jskonst/companyLamp/mech/README.md

# Корпус лампы под плафон VL0079 (E14)

Параметрическая модель OpenSCAD. Плафон **VL0079** (белый пластик, E14, усечённый конус) ставится нижним краем (~101 мм) в **мелкий паз** основания (`SEAT_DEPTH = 6` мм, как `depth` в эскизе) и прижимается сверху **кольцом на N_SNAPS = 6 защёлках** (как `CaseCap.scad`, резьба заменена защёлками).

Библиотека: [BOSL2](https://github.com/BelfrySCAD/BOSL2), лежит в `mech/lib/BOSL2` (из списка openscad.org/libraries). Используются `tube`, `cyl`, `cuboid`, `prismoid`, `rect_tube`, `zrot_copies`, `grid_copies`, `torus`.

В `mech/lib/BOSL2` оставлены только `std.scad`, файлы, которые он подключает, `builtins.scad` и `LICENSE`. Для других модулей BOSL2 (threading, joiners и т.д.) скопируйте нужный файл из апстрима.

## Файлы
- `scad/params.scad` — все размеры, оценки помечены `[EST]`.
- `scad/lamp.scad` — модули и сборка, `PART = assembly | exploded | base | cover | latch_ring | pipe | led_ring`.
- `stl/` — `base.stl`, `cover.stl`, `latch_ring.stl`, `pipe.stl`, `led_ring.stl`.
- `renders/assembly.png`, `renders/exploded.png`.

## Узлы
- **Основание**: конус отсека электроники (BAY_H 40 мм), палуба под LED-кольцо, мелкий паз под край плафона: стакан снаружи + бортик 4 мм изнутри, снаружи стакана буртик под зубья. В центре декоративный «патрон E14», он же кабельный ввод провода ленты (Ø5).
- **Прижимное кольцо** (`latch_ring.stl`): кольцо 3 мм с конусным отверстием по профилю плафона, надевается на плафон сверху и давит на него у края; 6 лапок 8×1.6 мм вниз, зуб с фаской защёлкивается под буртик стакана. Снять: отжать лапки.
- **LED-кольцо** 86/72 мм (как `ring.scad`), 24 × WS2812 светят вверх в плафон.
- **Световод AP-индикатора**: канал Ø4 от бока корпуса к leds[0] (угол 0°). Видно, не снимая плафон.
- **Кнопка** GPIO16: отверстие Ø7 спереди, толкатель для тактовой 6×6.
- **USB-C** зарядки в задней стенке, рядом вентиляционные прорези. Ещё прорези в дне под платой питания.
- **Узлы на палубе основания** (висят вниз): стойки Lolin M2 (28×18, h 10), рамка платы питания 35×50 у задней стенки (USB-C наружу), 18650 поперёк по центру (отсек 22×77×20), Lolin спереди; (TP4056 + boost 5 В ≥2 А), отсек 18650 при `WITH_BATTERY=true`. **Крышка дна** на 3 защёлках — только прижимные рёбра снизу (под края платы питания, Lolin и два ложемента 18650) и петля под стяжку.

## Электрика (напоминание)
Лента только от 5 В (boost), никогда от 3.3 В. 1000 мкФ на входе ленты, 330 Ом в линию данных GPIO14, общая земля.

## Печать
- PETG (лучше пружинит, защёлки не ломаются) или ABS. PLA подходит, но тогда `SNAP_T = 1.8`.
- Основание печатать юбкой вверх без поддержек, крышку плашмя. Слой 0.2, 3 периметра.
- Печать с шарнирами (print-in-place) не нужна: 4 отдельные детали.

## Открытые вопросы
- Точные размеры VL0079: нижний диаметр (наружный и внутренний), верх, отверстие E14, высота, есть ли у края валик или буртик. Если есть, зуб защёлки лучше развернуть под него.
- Элемент питания: 18650 или LiPo 1S ~1000 мАч (тогда отсек меньше).
- Ревизия Lolin D1 mini (v3 / v4 / Pro), точная плата зарядки и boost.
- Перед печатью всей детали стоит напечатать пробное кольцо юбки с защёлками.
