jskonst/companyLamp/hardware/power.md

# Питание и электроника companyLamp (корпус VL0079)

Плата: Wemos/Lolin D1 mini (ESP8266). Корпус: `mech/scad` (`params.scad`).

## Цепь питания

```
USB-C (задняя стенка) → TP4056 + защита (DW01/FS8205) → шина АКБ 3.0–4.2 В (18650, WITH_BATTERY)
        → boost 5 В ≥2 А ─┬→ лента/кольцо WS2812 ×24 (5V, GND)
                          └→ D1 mini пин 5V → его LDO 3.3 В → логика ESP8266
Все GND общие (АКБ−/OUT−, boost, лента, D1 mini).
```

- Ленту **никогда** не питать от 3V3 D1 mini (LDO ~500 мА, лента до 1.44 А).
- Без АКБ (`WITH_BATTERY=false`): USB-C 5 В ≥2 А напрямую на шину 5 В.
- Boost подключать к выходу защиты (OUT+/OUT−), не к B+ напрямую.

## Токи

| Потребитель | Ток |
|---|---|
| 24 × WS2812, белый 100 % | до ~1.44 А (60 мА/шт) |
| ESP8266 Wi‑Fi AP+STA, пики | 300–400 мА (3.3 В) |
| Лимит в прошивке | `FastLED.setMaxPowerInVoltsAndMilliamps(5, 800)` |

Boost берёт из 18650 ~ I×5/(3.7×0.9): при 1.2 А на 5 В — ~1.8 А из АКБ. Ячейка ≥2 А разряда, зарядка TP4056 1 А (R_prog 1.2 кОм).

## Сигналы

| Функция | GPIO | D1 mini | Примечание |
|---|---|---|---|
| Данные WS2812 | 5 | D1 | 330 Ом последовательно у первого светодиода; 1000 мкФ/10 В между 5V–GND на входе кольца |
| Кнопка | 14 | D5 | `BTN_LEVEL 1` (на 3V3) → внешний 10 кОм на GND (у GPIO14 есть только pull-up, pull-down нет); отверстие Ø7 спереди, тактовая 6×6 |
| Индикатор AP | — | — | `leds[0]` кольца через световод Ø4 (`PIPE_D`), отдельного LED нет |
| PIR | **D6 / GPIO12** | — | `USE_PIR 0` по умолчанию; запасной вариант D7/GPIO13 |

Данные 3.3 В на ленте 5 В обычно работают; при сбоях — 74AHCT125 или питание ленты ~4.6 В через диод.

## Посадочные места (params.scad)

| Узел | Размер |
|---|---|
| Lolin D1 mini | 34.2×25.6 мм, отверстия 28×18, M2, стойки 10 мм |
| Плата питания (TP4056 + boost) | рамка 35×50 мм (повёрнута), USB-C на короткой стороне к задней стенке [EST — до реальной платы зарядки] |
| 18650 в держателе | отсек 22×77×20 мм (под держатель 1×18650) |
| Ячейка 18650 (`BATT_CELL`) | Ø18.5×70 мм, отдельно от держателя |
| USB-C | окно 9.5×3.6 мм, задняя стенка |
| Кабель ленты | Ø5 через декоративный E14 |

## Прошивка

Micro-USB D1 mini (CH340), `pio run -e d1_mini -t upload`, монитор 115200. Micro-USB Lolin внутри корпуса и снаружи недоступен: прошивка со снятой крышкой дна или по OTA (`pio run -e d1_mini_ota -t upload --upload-port <ip>`, пароль в README). USB-C на задней стенке — только зарядка/питание, не данные.
