jskonst/companyLamp/FEATURES.md

# WebLamp — спецификация

**Концепция:** несколько ламп в офисе/команде общаются через MQTT и реагируют друг
на друга. Каждая лампа — личный инструмент фокуса и коммуникации для одного человека.

**Железо:** ESP8266 (D1 Mini), кольцо из 24 адресных WS2812B, кнопка, PIR-датчик.

---

## Кольцо из 24 LED

Кольцо — основной экран лампы. 24 светодиода делятся на **6 секций по 4 LED**,
каждая секция соответствует одному из режимов. Нумерация секций по часовой стрелке.

```
Секция 1 (LED 0–3)   → режим «Лампа»
Секция 2 (LED 4–7)   → режим «Помодоро»
Секция 3 (LED 8–11)  → режим «Настроение»
Секция 4 (LED 12–15) → режим «Настроение команды»
Секция 5 (LED 16–19) → режим «Позвать на митинг»
Секция 6 (LED 20–23) → режим «Не беспокоить»
```

---

## Управление кнопкой — общая модель

| Жест | Действие |
|---|---|
| **1 клик** | Основное действие текущего режима |
| **2 клика** | Вторичное действие текущего режима |
| **Удержание** | Аналоговое действие (яркость, цвет) |
| **3 клика** | Следующий циклический режим: Лампа → Помодоро → Настроение → Лампа |
| **4 клика** | Вкл / выкл DND с возвратом в предыдущий режим |

DND не входит в обычный цикл режимов и включается отдельным жестом.

### Индикатор режима при переключении
При смене режима или переключении DND:
1. Кольцо гаснет.
2. Загорается секция текущего режима (цвет секции — фиксированный, см. таблицу режимов).
3. Через ~2 секунды кольцо возвращается к отображению активного режима.

---

## Режимы

### Режим 1 — Лампа (базовое освещение)

**Индикатор:** секция 1 горит тёплым белым.

**Кнопка:**

| Жест | Действие |
|---|---|
| 1 клик | Вкл / выкл |
| 2 клика | Следующий цвет (+шаг по HSV, 8 цветов по кругу) |
| Удержание | Яркость: растёт до 100%, затем убывает до 0%, направление меняется на границах |

**Внешние сигналы (MQTT):** могут временно прервать отображение (мигнуть при
входящем сигнале), после завершения лампа возвращается к своему состоянию.

---

### Режим 2 — Помодоро

**Индикатор:** секция 2 горит оранжевым.

**Суть:** таймер по технике Помодоро — чередование рабочих интервалов и перерывов.
Прогресс визуализируется последовательным заполнением кольца LED-ами.

#### Настройки (веб-интерфейс)
- Длительность рабочего интервала (мин)
- Длительность короткого перерыва (мин)
- Длительность длинного перерыва (мин, после N помодоро)
- Количество помодоро до длинного перерыва
- Цвет рабочего интервала (используется как сигнал «не беспокоить»)

#### Визуализация прогресса
- Кольцо заполняется по часовой стрелке пропорционально прошедшему времени.
- Цвет заполнения: **рабочий цвет** во время работы, **зелёный** во время перерыва.
- Незаполненные LED выключены или очень тусклые (фоновая подсветка).

#### Состояния и кнопка

| Состояние | 1 клик | 2 клика |
|---|---|---|
| **Ожидание** (таймер не запущен) | Запустить первый интервал | — |
| **Идёт интервал** | Пауза / продолжить | Пропустить к следующему интервалу |
| **Интервал завершён** (мигает) | Подтвердить (мигание стоп) | — |
| **Подтверждено** (ждёт запуска) | Запустить следующий интервал | Пропустить следующий интервал |

При завершении интервала: кольцо **мигает** несколько раз и ждёт нажатия.
Первое нажатие — останавливает мигание. Второе — запускает следующий интервал.

#### Связь с MQTT
- Во время **рабочего** интервала автоматически рассылает сигнал «не беспокоить»
  (если лампа онлайн), используя настроенный рабочий цвет.
- Перерыв — сигнал «не беспокоить» снимается.

#### Офлайн
Помодоро работает полностью локально без MQTT.

---

### Режим 3 — Настроение

**Индикатор:** секция 3 горит цветом текущего настроения пользователя.

**Суть:** пользователь выставляет своё настроение цветом от зелёного (хорошо)
через жёлтый к красному (плохо). Отправляется в сеть и учитывается в среднем
настроении команды.

**Цветовая шкала настроения:**
```
Зелёный (120°) → Жёлто-зелёный → Жёлтый (60°) → Оранжевый → Красный (0°)
    Отлично                          Нормально                     Плохо
```

#### Кнопка

| Жест | Действие |
|---|---|
| Удержание | Прокрутка цвета настроения (зелёный → красный → зелёный) |
| 1 клик | Подтвердить и отправить настроение (если онлайн) |

Настроение также можно выставить через веб-интерфейс.

#### MQTT
- При подтверждении отправляет HSV-оттенок на брокер.
- Настроение **сбрасывается ежедневно** (в 00:00 или при перезагрузке на следующий день).

#### Офлайн
Настроение сохраняется локально, публикуется при восстановлении связи.

---

### Режим 4 — Настроение команды

**Индикатор:** секция 4 горит цветом среднего настроения.

**Суть:** только чтение. Показывает среднее настроение всех ламп в сети за
текущий день. Обновляется при получении нового значения настроения от коллег.

**Визуализация:**
- Всё кольцо горит цветом среднего настроения (тот же диапазон зелёный–красный).
- Если данных нет — кольцо тускло белое или не горит.

**Кнопка:** нет активных действий (только общий переход по 3 кликам и DND по 4 кликам).

**Сброс:** ежедневно, вместе с личным настроением.

---

### Режим 5 — Позвать на митинг

**Индикатор:** секция 5 горит синим.

**Суть:** одно нажатие рассылает сигнал всем лампам в сети — у всех **мигают**
лампы, привлекая внимание.

#### Кнопка

| Жест | Действие |
|---|---|
| 1 клик | Отправить сигнал митинга (мигание всех ламп в сети) |
| 2 клика | Подтвердить участие во входящем сигнале митинга |

#### Входящий сигнал
- Все лампы получают сигнал и **мигают** независимо от текущего режима.
- Мигание продолжается до нажатия кнопки или таймаута (~30 сек).
- Лампы в режиме «Не беспокоить» реагируют тише (без мигания, слабая подсветка).

#### Офлайн
Режим недоступен — секция отображается тускло серым.

---

### Режим 6 — Не беспокоить

**Индикатор:** секция 6 горит красным.

**Суть:** пользователь сигнализирует коллегам «я занят». Лампа физически видна
окружающим. Остальные лампы получают сигнал по MQTT и смягчают свои уведомления.

#### Кнопка

| Жест | Действие |
|---|---|
| 1 клик | Вкл / выкл режим «Не беспокоить» |

#### Визуализация
- Всё кольцо горит красным (настраиваемый оттенок) при активном DND.
- Медленная пульсация для привлечения внимания окружающих.

#### Влияние на другие лампы (MQTT)
- Входящий сигнал «Позвать на митинг» отображается тише, если получатель в DND.

#### Офлайн
DND работает локально (визуально), но не транслируется коллегам.

---

## Поведение в зависимости от сети

### Онлайн (MQTT подключён)
- Все режимы работают в полную силу.
- Входящие сигналы могут временно прерывать текущее отображение.
- Приоритет входящих сигналов (по убыванию):
  1. Сигнал митинга
  2. Изменение DND коллеги
  3. Изменение настроения коллеги
  4. Heartbeat

### Офлайн (MQTT отключён, WiFi активен)
Переключение в офлайн-режим — через веб-интерфейс.
- **Работают локально:** лампа, помодоро, личное настроение, DND (визуально).
- **Недоступны:** настроение команды, позвать на митинг, трансляция DND.
- Секции недоступных режимов (4, 5) отображаются тускло серым.

---

## MQTT протокол

### Топики
```
GWL:<lamp>/heartbeat   → "1" (каждые 8 сек)
GWL:<lamp>/mood        → uint8, HSV hue 0–120 (120=зелёный, 0=красный)
GWL:<lamp>/dnd         → "0" | "1"
GWL:<lamp>/meeting     → имя лампы-инициатора
GWL:<lamp>/pomodoro    → "work:<color>" | "break" | "idle"
GWL:<lamp>/pir         → "0" | "1"
```

Каждая лампа **публикует** в свой топик и **подписывается** на топики остальных.
Список удалённых ламп настраивается в веб-интерфейсе.

### Heartbeat и онлайн-статус
- Период публикации: 8 секунд.
- Таймаут: 18 секунд без пакета → лампа считается офлайн.

---

## PIR-датчик

- Состояние публикуется через MQTT.
- Флаг удерживается 60 секунд после последнего срабатывания.
- Управляется через `USE_PIR` (0 = выключен).
- Используется для уточнения приоритета уведомлений (если PIR не активен —
  человека нет на месте, уведомления менее приоритетны).

---

## Веб-интерфейс

### WiFi
- SSID / пароль, кнопка «Подключить», переключатель «Закрывать AP»

### MQTT
- Имя этой лампы (`local`)
- Список удалённых ламп (`remote`, через запятую)
- Хост и порт брокера
- Переключатель «Офлайн-режим» (игнорировать MQTT-сигналы)

### Помодоро
- Длительность рабочего, короткого и длинного перерыва (мин)
- Кол-во помодоро до длинного перерыва
- Рабочий цвет (HSV)

### Управление светом
- Питание, яркость, цвет (в режиме «Лампа»)

### Статус (только чтение)
- WiFi / MQTT подключение
- Текущий режим
- Настроение команды (цвет + кол-во участников)

---

## Smoke-checklist

Короткая ручная проверка после изменений:

1. Boot без WiFi: AP поднят, web-интерфейс доступен.
2. Подключение к WiFi: лампа получает IP, MQTT reconnect стабилен.
3. `1 клик` в каждом режиме: одинаковый power toggle.
4. DND: кнопка (`4 клика`) и web-переключатель дают одинаковое состояние и индикатор.
5. Смена режима кнопкой (`3 клика`) и web tabs не оставляет висящую индикацию.

---

## Персистентность (GyverDB / LittleFS)

| Ключ | Тип | По умолчанию |
|---|---|---|
| `ssid` / `pass` | String | `""` |
| `local` | String | `"AG_lamp_1"` |
| `remote` | String | `"AG_lamp_2"` |
| `host` / `port` | String / uint16 | `"broker.mqttdashboard.com"` / `1883` |
| `ip` | String | `"0.0.0.0"` |
| `close_ap` | bool | `true` |
| `power` | bool | `false` |
| `bright` | uint8 | `20` |
| `color` | uint8 | `0` (белый) |
| `mode` | uint8 | `0` (лампа) |
| `mood` | uint8 | `120` (зелёный) |
| `mood_date` | uint32 | `0` (Unix-день) |
| `dnd` | bool | `false` |
| `offline` | bool | `false` |
| `pomo_work` | uint16 | `25` |
| `pomo_short` | uint16 | `5` |
| `pomo_long` | uint16 | `15` |
| `pomo_count` | uint8 | `4` |
| `pomo_color` | uint8 | `0` (красный) |

---

## Статус реализации

| Функция | Статус |
|---|---|
| Управление светом (power/bright/color) | ✅ Реализовано |
| Кнопка — 1/2 клика и удержание | ✅ Реализовано |
| Загрузочная анимация | ✅ Реализовано |
| Веб-интерфейс (WiFi, базовое управление) | ✅ Реализовано |
| LittleFS персистентность (GyverDB) | ✅ Реализовано |
| **Режим 1 — Лампа** | 🔶 Частично (нет слайдера цвета в UI) |
| **Режим 2 — Помодоро** | ⬜ Не реализовано |
| **Режим 3 — Настроение** | ⬜ Не реализовано |
| **Режим 4 — Настроение команды** | ⬜ Не реализовано |
| **Режим 5 — Позвать на митинг** | ⬜ Не реализовано |
| **Режим 6 — Не беспокоить** | ⬜ Не реализовано |
| Переключение режимов (3 клика) и DND (4 клика) | ✅ Реализовано |
| Индикатор режима на кольце (секции) | ⬜ Не реализовано |
| MQTT синхронизация | ⬜ Не реализовано (инфраструктура есть) |
| Офлайн-режим (игнорировать MQTT) | ⬜ Не реализовано |
| PIR-датчик | ⬜ Выключен (USE_PIR=0) |
| Heartbeat | ⬜ Не реализовано |
