jskonst/companyLamp/plans/PLAN_03b_STARTUP_SOFT_WIFI_ANIM.md

# План 03b — Мягкая WiFi-индикация на старте

## Цель
Убрать резкие/яркие мигания при попытке подключения к WiFi и сделать индикацию более спокойной:
- плавная,
- зелёная,
- без коротких «строб»-эффектов.

План уточняет поведение из `PLAN_03_STARTUP_WIFI.md` и применяется поверх него.

---

## 03b.1 Принцип индикации

Во время попытки подключения к WiFi:
- использовать только зелёную палитру (`CRGB::Green` + приглушённые оттенки),
- не использовать белые вспышки,
- не делать быстрые импульсы с короткими задержками (типа 50–120 мс).

Визуально это должен быть «спокойный прогресс», а не тревожный сигнал.

---

## 03b.2 Изменение поведения при ожидании WiFi

### Было
- каждые 5 секунд короткий белый пульс.

### Стало
- каждые 5 секунд мягкий зелёный «вдох-выдох» (или один плавный подъём/спад яркости).

Рекомендуемые параметры:
- минимальная яркость: `8..16`,
- максимальная яркость: `60..90`,
- длительность одного мягкого пульса: `700..1200 мс`,
- без мгновенного переключения в чёрный.

---

## 03b.3 Успешное подключение

После успешного подключения:
- вместо белых вспышек сделать 1–2 коротких зелёных подтверждения,
- подтверждение должно быть мягче основного «blink» из старой версии,
- затем переход к обычному рендеру текущего режима.

---

## 03b.4 AP-режим

AP-режим не меняется:
- как и раньше, синий `loadAnimation(CRGB::Blue)`.

---

## 03b.5 Изменения файлов

| Файл | Действие |
|---|---|
| `src/startup.ino` | Заменить белый `showWifiWaitPulse()` на мягкий зелёный пульс |
| `src/startup.ino` | Смягчить `showWifiConnectedBlink()` (зелёный, без резких вспышек) |
| `plans/PLAN_03_STARTUP_WIFI.md` | (опц.) добавить ссылку на 03b как уточнение визуала |

---

## Критерии приёмки

- [ ] При попытке подключения нет белых вспышек
- [ ] Вся стартовая индикация подключения — зелёная и плавная
- [ ] Нет резких быстрых миганий, воспринимаемых как «строб»
- [ ] После успеха есть мягкое зелёное подтверждение и переход в рабочий режим
- [ ] AP-режим остался синим, без регрессий
