jskonst/companyLamp/mech/renders/exploded.png

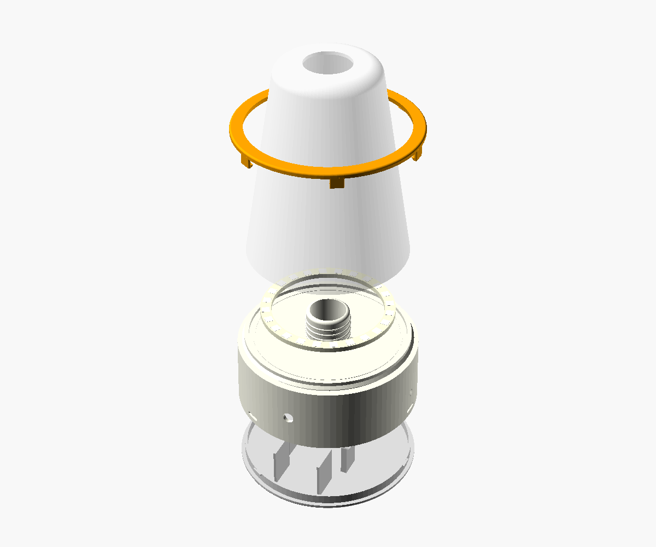
mech/renders/exploded.png
