jskonst/companyLamp/mech/stl/latch_ring.stl

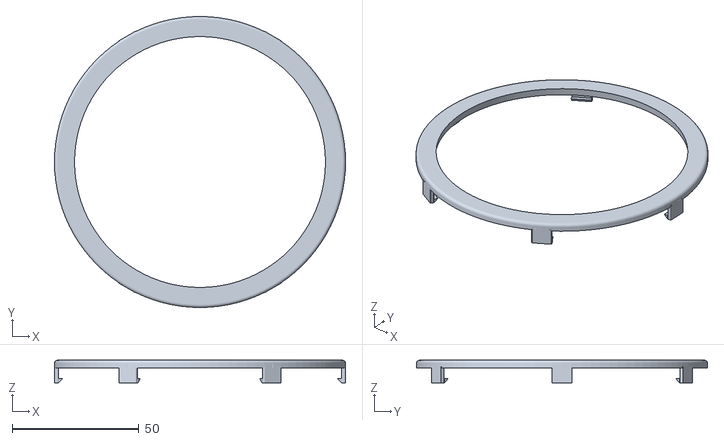
[picture p2: CAD file, 2026-11-11]
mech/stl/latch_ring.stl
114.6 x 114.6 x 8.90
