jskonst/companyLamp/mech/stl/base.stl

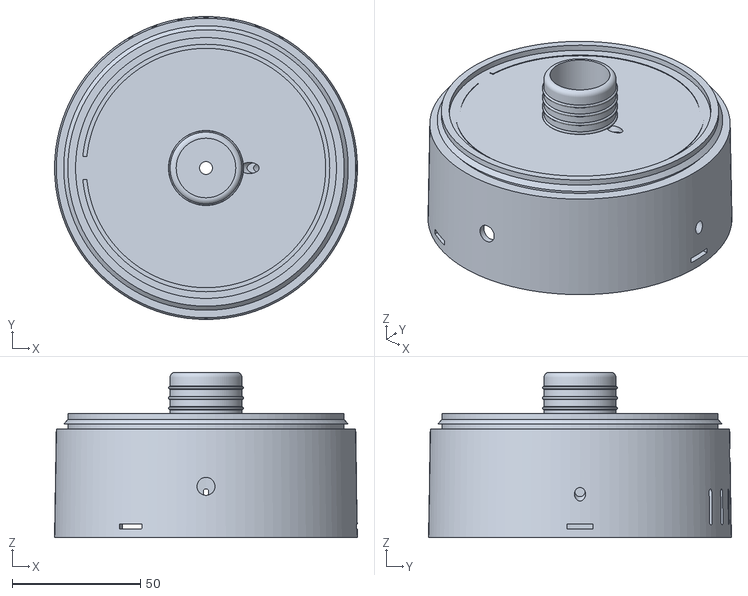
[picture p3: CAD file, 2026-11-11]
mech/stl/base.stl
118.0 x 118.0 x 64.4
