jskonst/companyLamp/mech/stl/cover.stl

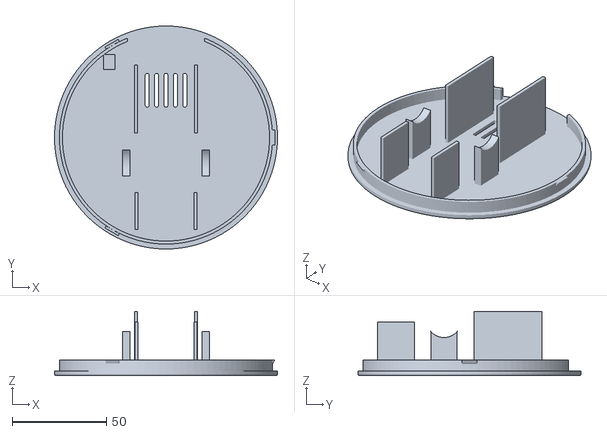
[picture p4: CAD file, 2026-11-11]
mech/stl/cover.stl
118.0 x 118.0 x 34.1
