jskonst/companyLamp/mech/stl/led_ring.stl

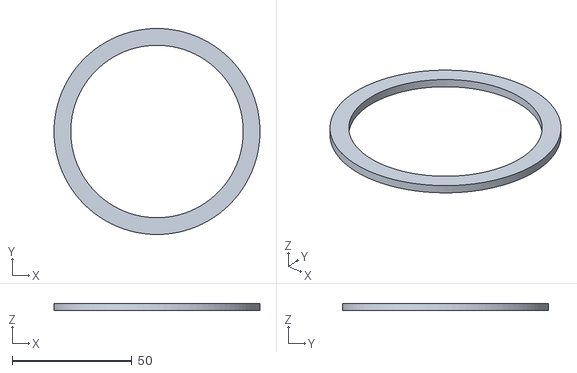
[picture p5: CAD file, 2026-10-31]
mech/stl/led_ring.stl
86.0 x 86.0 x 3.10
