jskonst/companyLamp/mech/stl/pipe.stl

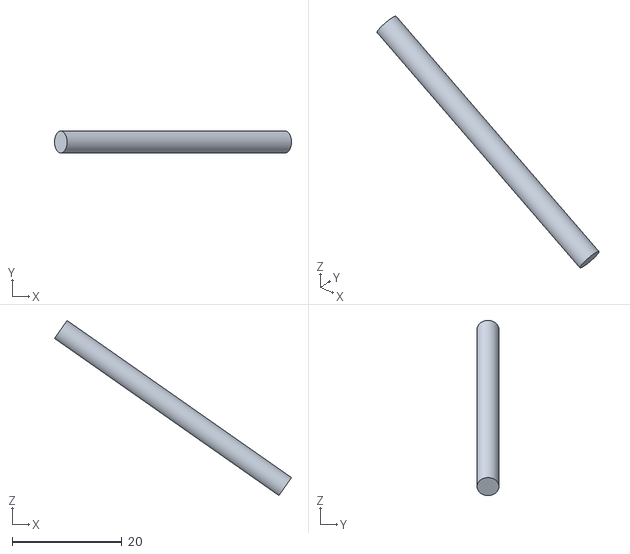
[picture p6: CAD file, 2026-10-31]
mech/stl/pipe.stl
43.3 x 4.00 x 32.0
