jskonst/companyLamp/mech/scad/params.scad

// companyLamp — корпус под плафон VL0079 (E14, белый пластик, усечённый конус,
// узкое отверстие сверху, открытое дно). Все размеры в мм.
// [EST] = оценка, уточнить штангенциркулем.
// Размеры из эскиза пользователя (config.scad): diameter=86, inner_d=72,
// lamp_lower_d=101, cap_thikness=5, lamp_thikness=2, height=15, border=5, depth=10.

$fn = 96;

// ---- Плафон VL0079 ----
SHADE_LOWER_D   = 101;   // нижний (открытый) край, наружный  [EST, эскиз]
SHADE_WALL      = 2;     // толщина стенки                     [EST, эскиз]
SHADE_TOP_D     = 62;    // верх снаружи                       [EST, фото]
SHADE_TOP_HOLE  = 29;    // отверстие под E14                  [EST]
SHADE_H         = 125;   // высота                             [EST, фото]
SEAT_DEPTH      = 6;     // глубина мелкого паза под край плафона (5..8, эскиз: depth)

// ---- Прижимное кольцо на защёлках (вместо резьбы CaseCap.scad) ----
N_SNAPS      = 6;     // число защёлок 4..6
SNAP_W       = 8;     // ширина лапки
SNAP_T       = 1.6;   // толщина лапки (PETG 1.6, PLA 1.8)
SNAP_HOOK    = 1.6;   // вылет зуба внутрь (зацеп = SNAP_HOOK - SNAP_GAP)
SNAP_GAP     = 0.3;   // зазор лапки к буртику
FIT          = 0.3;   // зазор края плафона в пазу
COLLAR_WALL  = 3;     // стенка стакана паза
LIP_H        = 4;     // внутренний бортик паза (центрирует плафон изнутри)
RING_T       = 3;     // толщина прижимного кольца (cap_head_thikness)
BEAD         = 1.6;   // вылет буртика на стакане под зубья
BEAD_Z       = 1.8;   // высота полки буртика над палубой
HOOK_H       = 1.6;   // высота зуба (плоская верхняя грань под полку)
WIRE_D       = 6;     // проход проводов ленты (5V, GND, GPIO14) через палубу
WIRE_ANG     = 180;   // угол прохода (напротив световода на 0°)
WIRE_NOTCH   = 9;     // ширина выреза в бортике

// ---- Корпус ----
WALL         = 2.4;
BAY_H        = 40;    // высота отсека электроники (35..45)
BASE_BOT_D   = 118;   // низ основания (лёгкий конус к плафону)
FLOOR        = 2.4;

// ---- LED-кольцо (ring.scad эскиза) ----
LED_RING_OD  = 86;    // diameter
LED_RING_ID  = 72;    // inner_d
LED_N        = 24;
LED_PCB_T    = 1.6;

// ---- E14 декор + кабельный ввод ----
E14_OD       = 28;    // имитация патрона E14  [EST]
E14_H        = 22;
CABLE_D      = 5;     // проход провода ленты

// ---- Электроника ----
LOLIN        = [34.2, 25.6, 1.2];  // Wemos D1 mini v3/v4   [EST rev]
LOLIN_HOLES  = [28, 18];           // M2 / саморез
STANDOFF_H   = 10;
POWER_PCB    = [35, 50, 1.6];      // TP4056 + boost 5V 2A, 35 по X, 50 по Y  [EST]
POWER_FRAME_H = 4;                 // высота рамки = высота платы над полом крышки
POWER_Y2     = 51.6;               // задний край рамки: подобран, чтобы углы платы и Lolin не задевали конус стенки
// разъём USB-C — по центру задней короткой стороны платы, сверху
USBC_X       = 0;                  // смещение разъёма по X от оси платы  [EST]
USBC_BODY_H  = 3.2;                // высота корпуса разъёма над платой
USBC         = [9.5, 3.6];         // окно USB-C в задней стенке
WITH_BATTERY = true;
BATT_BAY     = [22, 77, 20];       // держатель 18650 (ячейка ~70, держатель ~77)  [EST]
BATT_CELL    = [18.5, 70];         // ячейка Ø × длина (с защитой до 70)
BAY_GAP      = 0.5;                // зазор между узлами на крышке

// ---- Кнопка / индикатор ----
BTN_D        = 7;     // тактовая 6x6 с толкателем
PIPE_D       = 4;     // световод к leds[0]
VENT_SLOTS   = 7;

// ---- Производные ----
GROOVE_OD  = SHADE_LOWER_D + 2*FIT;                      // паз снаружи
GROOVE_ID  = SHADE_LOWER_D - 2*SHADE_WALL - 2*FIT;       // паз внутри (бортик)
COLLAR_OD  = GROOVE_OD + 2*COLLAR_WALL;
ARM_R      = COLLAR_OD/2 + BEAD + SNAP_GAP;              // внутренняя грань лапок
RING_OD    = 2*(ARM_R + SNAP_T);
BODY_TOP_D = RING_OD + 2;                                // верх основания под кольцо
// диаметр плафона на высоте z над нижним краем (конус)
function shade_d(z) = SHADE_LOWER_D - (SHADE_LOWER_D-SHADE_TOP_D)*z/SHADE_H;

// ---- Раскладка крышки вдоль Y: зад (+Y, USB-C) -> перед (-Y, кнопка) ----
// плата питания у задней стенки, 18650 поперёк по центру, Lolin спереди
POWER_C   = [0, POWER_Y2 - (POWER_PCB.y+2.4)/2];
BATT_C    = [0, POWER_C.y - (POWER_PCB.y+2.4)/2 - BAY_GAP - (BATT_BAY.x+2.4)/2];
LOLIN_C   = [0, BATT_C.y - (BATT_BAY.x+2.4)/2 - BAY_GAP - LOLIN.y/2];
USBC_Z    = BAY_H - POWER_FRAME_H - POWER_PCB.z - USBC_BODY_H/2;   // ось окна USB-C (плата висит под палубой, разъём снизу)
