jskonst/companyLamp/mech/renders/assembly.png

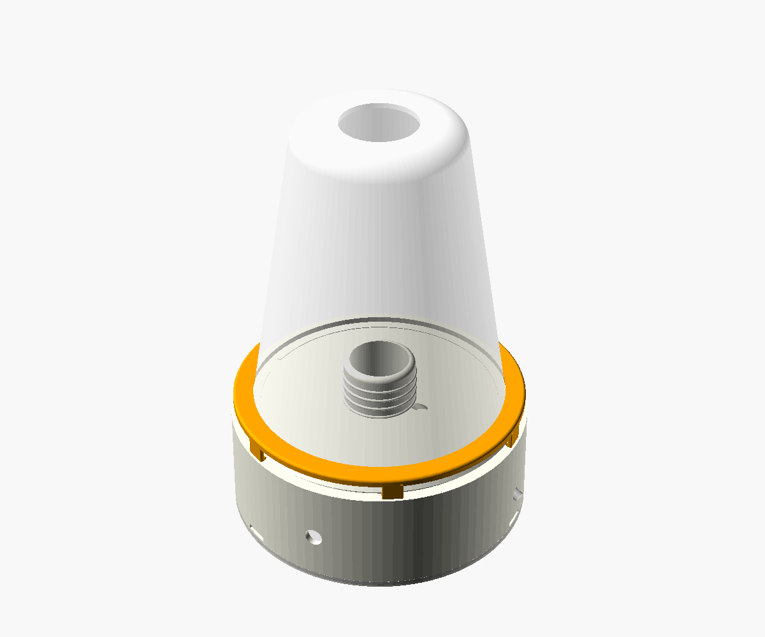
mech/renders/assembly.png
