jskonst/companyLamp/plans/PLAN_02_FIX_BASICS.md

# План 02 — Базовые исправления и чистка

## Цель
Устранить накопившиеся баги и мёртвый код до начала разработки новых функций.
Это фундамент — без него баги будут маскировать новые проблемы.

---

## 2.1 Слайдер цвета в веб-интерфейсе

**Файл:** `src/sets.cpp`, функция `build()`

Ключ `kk::color` есть в БД, но его нет в UI. Добавить:
```cpp
b.Slider(kk::color, "Цвет", 0, 255, 1);
```
Поставить после слайдера яркости.

**Проверка:** открыть веб-интерфейс → слайдер цвета присутствует → потянуть → лента меняет цвет.

---

## 2.2 Порт MQTT — хранить как число

**Файл:** `src/sets.cpp` + `src/sets.h`

Сейчас порт хранится строкой и парсится при каждом чтении:
```cpp
db.init(kk::port, "1883");                       // строка
uint16_t port() { return String(db[kk::port]).toInt(); }  // парсинг
```

Заменить на:
```cpp
db.init(kk::port, (uint16_t)1883);               // число
uint16_t port() { return (uint16_t)db[kk::port]; }
```

В `build()` поменять:
```cpp
b.Input(kk::port, "Порт", "1883");  // было
b.Input(kk::port, "Порт", 1883);    // стало (числовой тип)
```

---

## 2.3 Удалить мёртвые переменные

**Файл:** `src/WebLamp_v1.0.ino`

Удалить неиспользуемые глобалы:
```cpp
bool pirFlag = 0;       // нигде не читается
bool startFlag = 0;     // нигде не используется
Timer hbTmr(8000);      // только в закомментированном коде
Timer onlineTmr(18000, false);  // то же
Timer pirTmr(60000, false);     // то же
const uint8_t hLen = strlen(MQTT_HEADER);  // нигде не используется
```

`winkFlag` — оставить (3 клика его устанавливают; обработка будет в Плане 05).

---

## 2.4 Убрать двойную инициализацию кнопки

**Файл:** `src/WebLamp_v1.0.ino`, функция `setup()`

```cpp
btn.init(BTN_PIN_MODE, BTN_LEVEL);  // удалить — уже сделано в конструкторе
```

---

## 2.5 Удалить неиспользуемые библиотеки

**Файл:** `platformio.ini`

```ini
; удалить:
gyverlibs/GyverPortal@^3.6.6
gyverlibs/EEManager@^2.0.1
```

**Файл:** `src/WebLamp_v1.0.ino`

```cpp
#include <EEPROM.h>  // удалить
```

**Файл:** `src/portal.ino` — удалить файл целиком (только `return false;` внутри).

**Файл:** `src/func.ino` — удалить весь закомментированный код, оставить только
`loadAnimation()` (перенести в `func.ino` или в main).

---

## 2.6 Упростить startup-анимацию

**Файл:** `src/WebLamp_v1.0.ino`, функция `setup()`

Сейчас паттерн `show(); delay(2); show();` повторяется 6+ раз. Вынести в хелпер:
```cpp
static void showBlack() {
  fill_solid(leds, LED_AMOUNT, CRGB::Black);
  FastLED.show();
}
```
И заменить все блоки `for(p) leds[p] = Black; show(); delay(2); show();`.

---

## Проверка всего этапа

- [ ] Код собирается без ошибок и предупреждений
- [ ] Размер прошивки не вырос (ожидается небольшое уменьшение из-за удалённых либ)
- [ ] Веб-интерфейс открывается, слайдер цвета присутствует и работает
- [ ] Порт в веб-интерфейсе — числовое поле, значение сохраняется корректно
- [ ] Запуск: зелёная анимация → 3× белое мигание → состояние из памяти
