jskonst/companyLamp/(commit log)

2026-04-19 fixwd button behavior
2026-04-19 fixed connection to wifi
    [sets.cpp, sets.h, startup.ino]
2026-04-22 add pomodoro timer
2026-10-30 Офлайн-управление: неблокирующий Wi-Fi, резервная точка доступа и captive portal
2026-10-30 FSL-план: companyLamp-XXXXXX/companylamp.local, Serial 115200, release, фикс payload OOB, неблокирующие wink/мигание, ресинк MQTT, пароль пусто=не менять, индикатор AP, memory.update IP
2026-10-31 mech: параметрический корпус под плафон VL0079 на защёлках (BOSL2)
    [base.stl, cover.stl, lamp.scad, led_ring.stl, params.scad, pipe.stl]
2026-10-31 mech: оставить в BOSL2 только std и зависимости (#5)
2026-10-31 hardware: power.md — цепь питания, токи, пины и посадочные места под корпус VL0079 (#4)
2026-11-11 PIR: D5 -> D6 (GPIO12), D5/GPIO14 — данные ленты; PIR выключен по умолчанию (#6)
2026-11-11 mech: мелкий паз + прижимное кольцо на защёлках (по эскизу), раскладка электроники из #7 (#9)
    * mech: мелкий паз под плафон VL0079 + прижимное кольцо на защёлках, раскладка электроники из #7
    * mech: зацеп защёлок кольца ~1.3 мм, проход проводов ленты через палубу и вырез в бортике
    * mech: Lolin, рамка питания и отсек 18650 на палубе основания; крышка — только прижимные рёбра
    ---------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
    [base.stl, cover.stl, lamp.scad, latch_ring.stl, params.scad]
2026-11-11 hardware: power.md — посадочные места по PR #7 (отсек 22×77×20, BATT_CELL, плата 35×50, USB-C [EST]) (#8)
2026-11-11 docs: протокол группы ламп (MQTT, настроение, среднее, автономный режим) (#10)
2026-11-11 infra: собственный брокер Mosquitto для ламп (#11)
    Docker Compose с eclipse-mosquitto:2.0.22, обязательная аутентификация
    и ACL lamp/<группа>/#, install.sh для Ubuntu/Debian VPS и опциональный
    TLS 8883 через Let's Encrypt. Секреты и данные в репозиторий не входят.
2026-11-11 Группа ламп: MQTT по протоколу, среднее настроение и OTA (#12)
    Пара local/remote заменена группой до 20 ламп: id из chip id,
    топики lamp/<group>/<id>/{status,state,wink}, Last Will offline.
    Ключ EEPROM сменён на 'b', публичный брокер убран. Подключение
    к брокеру не блокирует цикл. Добавлены OTA, лимит тока 800 мА
    и пароль точки доступа.
2026-11-11 Документация: как пользоваться лампой и топики группы в брокере (#13)
    В README раздел для людей без протокола: жесты, индикаторы кольца,
    первая настройка и прошивка кабелем до сборки. Технические абзацы
    сверены с кодом. В infra/broker/README убрано описание старой пары.
2026-11-11 hardware: pinout as in refactor (strip D1/GPIO5, button D5/GPIO14)
2026-11-11 docs: протокол MQTT под режимы refactor (pomodoro, dnd, mood, meeting)
    Описывает фактические топики и payload ветки refactor, статус/LWT
    переноса на main и расхождение с ACL брокера: в прошивке нужен префикс lamp/.
2026-11-11 Port offline Wi-Fi, lamp/ MQTT, OTA and the 800 mA limit
    Keep refactor's modes, gestures and Settings UI. Topics are
    lamp/<group>/<chipid>/… with client id lamp-<chipid>, retained
    status and an offline LWT. Wi-Fi and MQTT reconnect in the
    background so a dead router or broker does not freeze the button
    or the ring. ArduinoOTA plus env d1_mini_ota updates a lamp whose
    USB port is inside the enclosure.
    [led_driver.cpp, mqtt.h, mqtt.ino, sets.cpp, sets.h, startup.ino]
